wheuer/LED-Dodecahedron/README.md

# LED-Dodecahedron

This repository tracks the most recent state of my LED dodecahedron project.

It's a mess and unpolished. For a more in depth look at the project and it's history see [my website](https://www.williamfheuer.com/project-portfolio).
