wheuer/LED-Dodecahedron/KiCad/LEDSphere/LEDSphere.kicad_pcb

## KiCad design KiCad/LEDSphere/LEDSphere.kicad_pcb (2025-01-10)

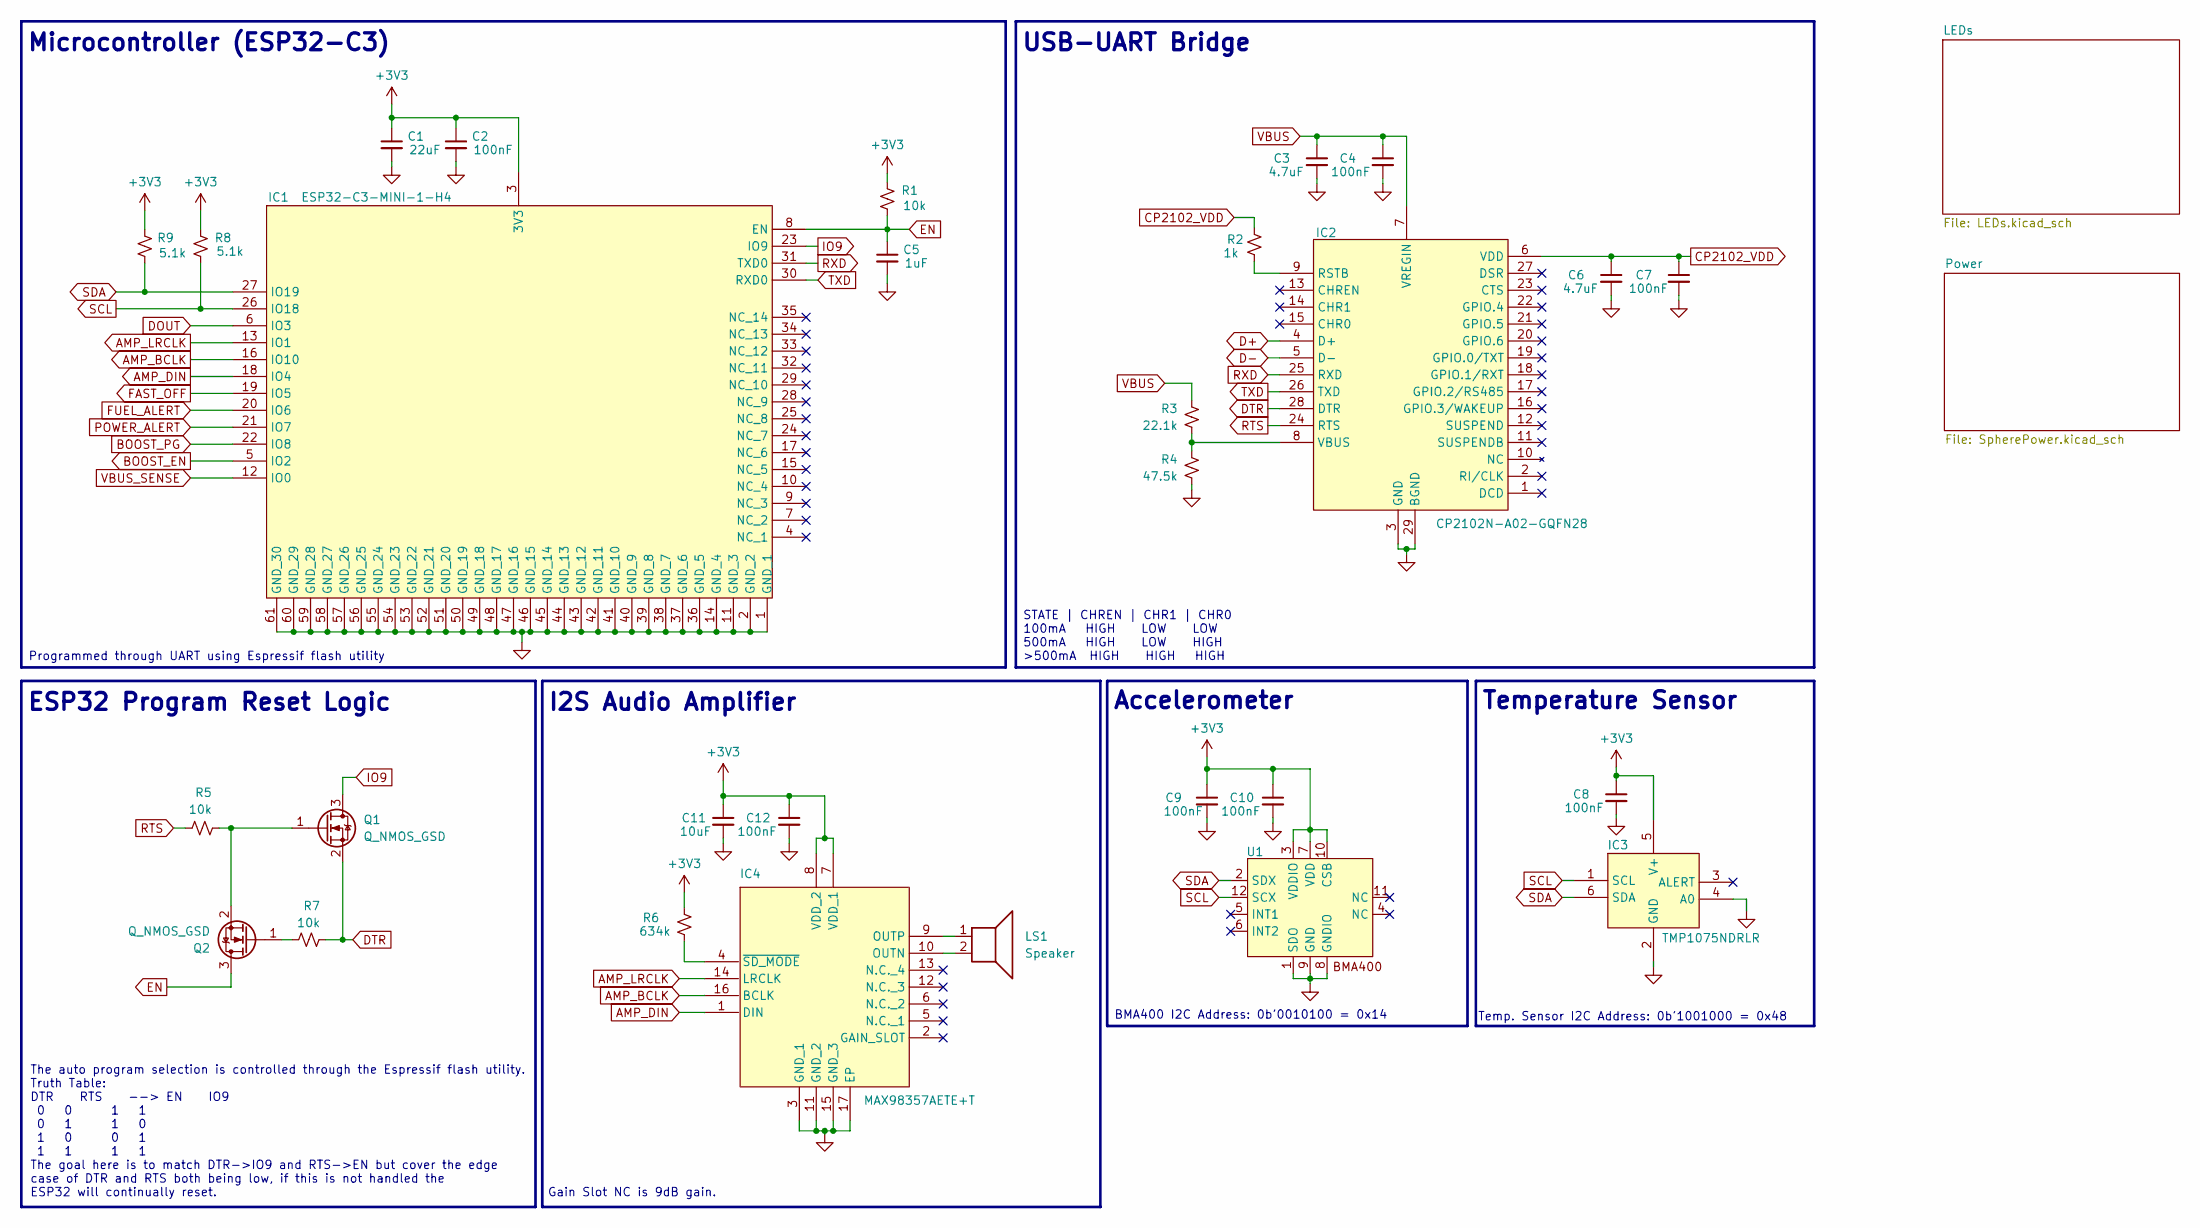
[picture p1: schematic LEDSphere.kicad_sch]

Parts:
C1: 22uF; C_0603_1608Metric
C2, C4, C7, C8, C9, C10, C12: 100nF; C_0402_1005Metric
C3, C6: 4.7uF; C_0402_1005Metric
C5: 1uF; C_0402_1005Metric
C11: 10uF; C_0603_1608Metric
IC1: ESP32-C3-MINI-1-H4; ESP32C3MINI1H4; Mouser Part Number 356-ESP32-C3-MINI1H4
IC2: CP2102N-A02-GQFN28; cp2102_QFN50P500X500X80-29N-D; Mouser Part Number 634-CP2102NA02GQFN28
IC3: TMP1075NDRLR; SOTFL50P160X60-6N; Mouser Part Number 595-TMP1075NDRLR
IC4: MAX98357AETE+T; QFN50P300X300X80-17N; Mouser Part Number 700-MAX98357AETE+T
LS1: Speaker; speakerPads
Q1, Q2: Q_NMOS_GSD; NMOS_SOT91P240X110-3N
R1, R5, R7: 10k; R_0402_1005Metric
R2: 1k; R_0402_1005Metric
R3: 22.1k; R_0402_1005Metric
R4: 47.5k; R_0402_1005Metric
R6: 634k; R_0402_1005Metric
R8, R9: 5.1k; R_0402_1005Metric
U1: BOSCH_LGA-12

Connections:
+3V3: C1.1, C2.1, C8.1, C9.1, C10.1, C11.1, C12.1, IC1.3 (3V3), IC3.5 (V+), IC4.7 (VDD_1), IC4.8 (VDD_2), R1.2, R6.2, R8.2, R9.2, U1.3 (VDDIO), U1.7 (VDD), U1.10 (CSB); also elsewhere on the board
AMP_BCLK: IC1.16 (IO10), IC4.16 (BCLK)
AMP_DIN: IC1.18 (IO4), IC4.1 (DIN)
AMP_LRCLK: IC1.13 (IO1), IC4.14 (LRCLK)
BOOST_EN: IC1.5 (IO2); also elsewhere on the board
BOOST_PG: IC1.22 (IO8); also elsewhere on the board
CP2102_VDD: C6.1, C7.1, IC2.6 (VDD), R2.1
D+: IC2.4 (D+); also elsewhere on the board
D-: IC2.5 (D-); also elsewhere on the board
DOUT: IC1.6 (IO3); also elsewhere on the board
DTR: IC2.28 (DTR), Q1.2 (S), R7.1
EN: C5.1, IC1.8 (EN), Q2.3 (D), R1.1
FAST_OFF: IC1.19 (IO5); also elsewhere on the board
FUEL_ALERT: IC1.20 (IO6); also elsewhere on the board
GND: C1.2, C2.2, C3.2, C4.2, C5.2, C6.2, C7.2, C8.2, C9.2, C10.2, C11.2, C12.2, IC1.1 (GND_1), IC1.2 (GND_2), IC1.11 (GND_3), IC1.14 (GND_4), IC1.36 (GND_5), IC1.37 (GND_6), IC1.38 (GND_7), IC1.39 (GND_8), IC1.40 (GND_9), IC1.41 (GND_10), IC1.42 (GND_11), IC1.43 (GND_12), IC1.44 (GND_13), IC1.45 (GND_14), IC1.46 (GND_15), IC1.47 (GND_16), IC1.48 (GND_17), IC1.49 (GND_18), IC1.50 (GND_19), IC1.51 (GND_20), IC1.52 (GND_21), IC1.53 (GND_22), IC1.54 (GND_23), IC1.55 (GND_24), IC1.56 (GND_25), IC1.57 (GND_26), IC1.58 (GND_27), IC1.59 (GND_28), IC1.60 (GND_29), IC1.61 (GND_30), IC2.3 (GND), IC2.29 (BGND), IC3.2 (GND), IC3.4 (A0), IC4.3 (GND_1), IC4.11 (GND_2), IC4.15 (GND_3), IC4.17 (EP), R4.2, U1.1 (SDO), U1.8 (GNDIO), U1.9 (GND); also elsewhere on the board
IO9: IC1.23 (IO9), Q1.3 (D)
unnamed: IC2.9 (RSTB), R2.2
unnamed: IC2.8 (VBUS), R3.2, R4.1
unnamed: IC4.10 (OUTN), LS1.2
unnamed: IC4.9 (OUTP), LS1.1
unnamed: IC4.4 (~SD_MODE), R6.1
unnamed: Q1.1 (G), Q2.2 (S), R5.1
unnamed: Q2.1 (G), R7.2
POWER_ALERT: IC1.21 (IO7); also elsewhere on the board
RTS: IC2.24 (RTS), R5.2
RXD: IC1.31 (TXD0), IC2.25 (RXD)
SCL: IC1.26 (IO18), IC3.1 (SCL), R8.1, U1.12 (SCX); also elsewhere on the board
SDA: IC1.27 (IO19), IC3.6 (SDA), R9.1, U1.2 (SDX); also elsewhere on the board
TXD: IC1.30 (RXD0), IC2.26 (TXD)
VBUS: C3.1, C4.1, IC2.7 (VREGIN), R3.1; also elsewhere on the board
VBUS_SENSE: IC1.12 (IO0); also elsewhere on the board

Notes on the sheet:
I2S Audio Amplifier
Gain Slot NC is 9dB gain.
Temperature Sensor
Microcontroller (ESP32-C3)
Programmed through UART using Espressif flash utility
BMA400 I2C Address: 0b'0010100 = 0x14
The auto program selection is controlled through the Espressif flash utility. Truth Table: DTR RTS --> EN IO9 0 0 1 1 0 1 1 0 1 0 0 1 1 1 1 1 The goal here is to match DTR->IO9 and RTS->EN but cover the edge case of DTR and RTS both being low, if this is not handled the ESP32 will continually reset.
STATE | CHREN | CHR1 | CHR0 100mA HIGH LOW LOW 500mA HIGH LOW HIGH >500mA HIGH HIGH HIGH
Temp. Sensor I2C Address: 0b'1001000 = 0x48
Accelerometer
USB-UART Bridge
ESP32 Program Reset Logic

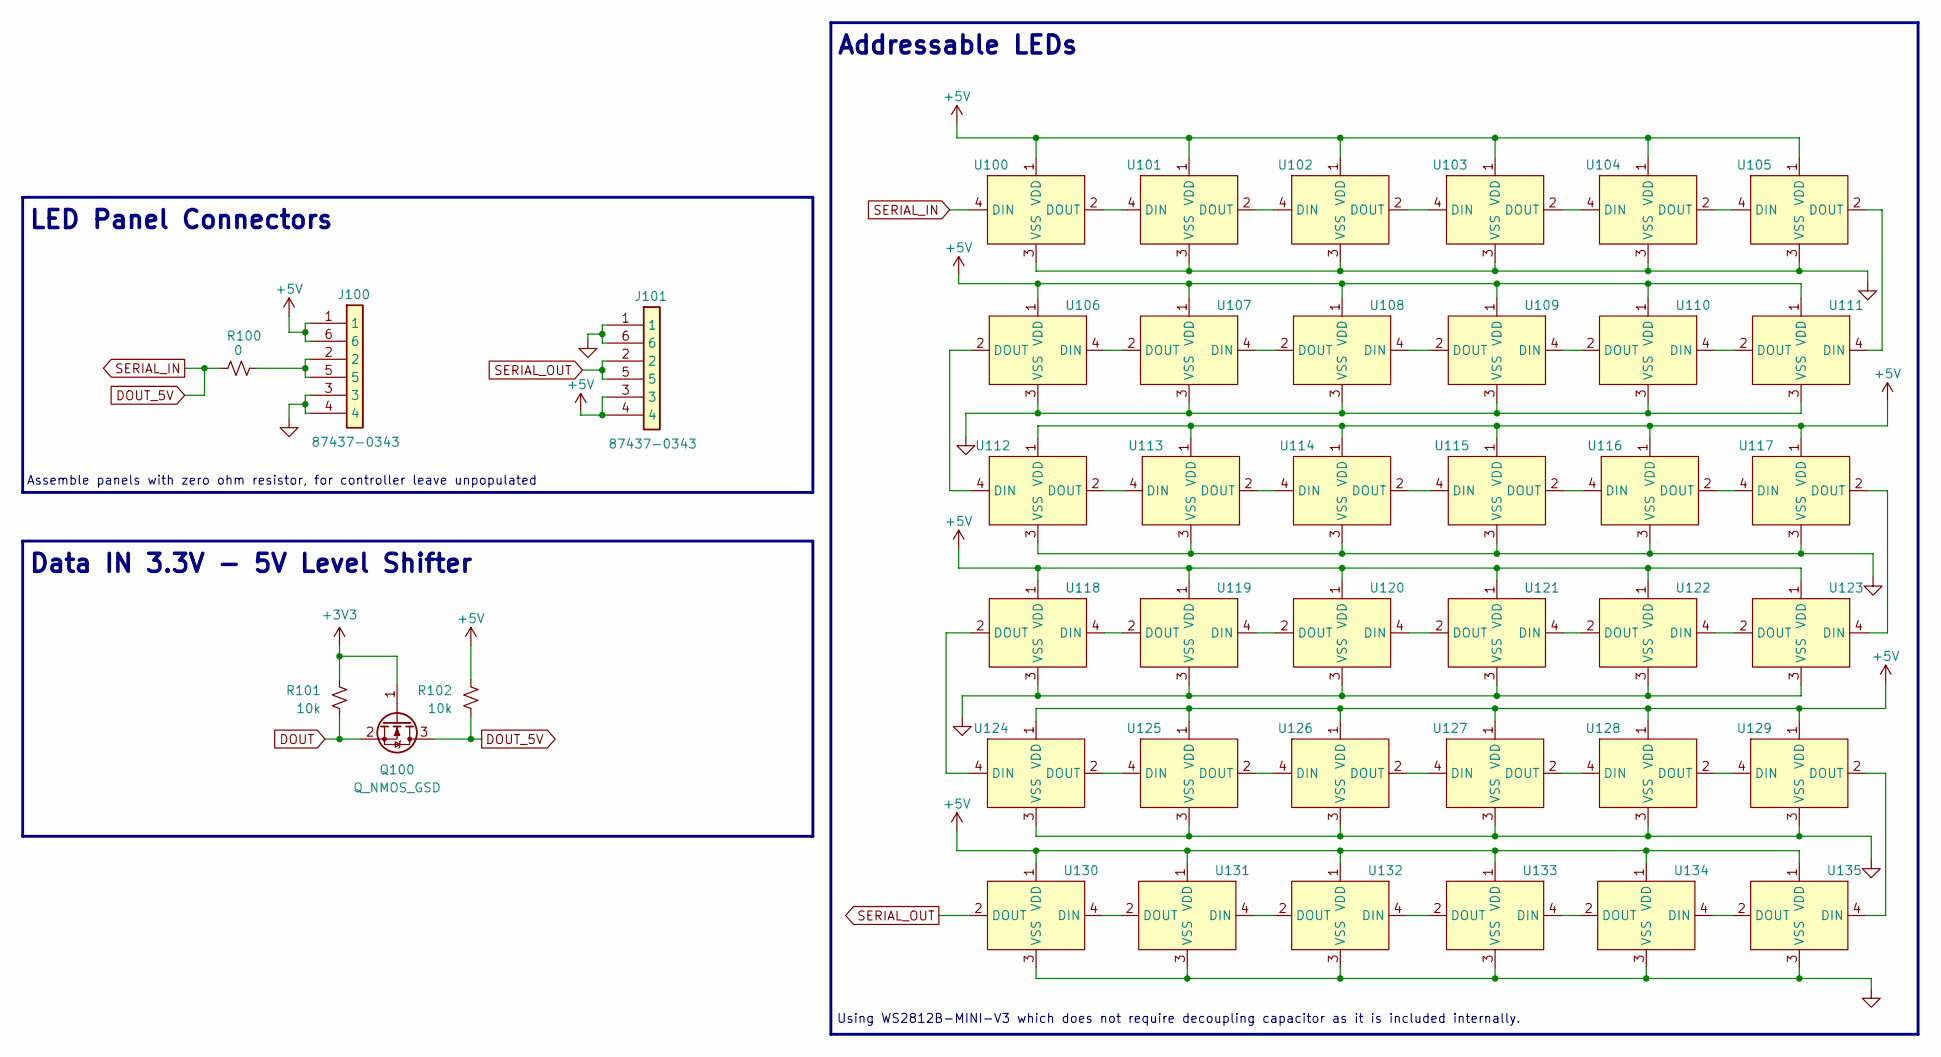
[picture p2: schematic LEDs.kicad_sch]

Parts:
J100, J101: 87437-0343; 874370343; Mouser Part Number 538-87437-0343
Q100: Q_NMOS_GSD; NMOS_SOT91P240X110-3N
R100: 0; R_0402_1005Metric
R101, R102: 10k; R_0402_1005Metric
U100, U101, U102, U103, U104, U105, U106, U107, U108, U109, U110, U111, U112, U113, U114, U115, U116, U117, U118, U119, U120, U121, U122, U123, U124, U125, U126, U127, U128, U129, U130, U131, U132, U133, U134, U135: WS2812-W-MINI

Connections:
+3V3: Q100.1 (G), R101.1; also elsewhere on the board
+5V: J100.1, J100.6, J101.3, J101.4, R102.1, U100.1 (VDD), U101.1 (VDD), U102.1 (VDD), U103.1 (VDD), U104.1 (VDD), U105.1 (VDD), U106.1 (VDD), U107.1 (VDD), U108.1 (VDD), U109.1 (VDD), U110.1 (VDD), U111.1 (VDD), U112.1 (VDD), U113.1 (VDD), U114.1 (VDD), U115.1 (VDD), U116.1 (VDD), U117.1 (VDD), U118.1 (VDD), U119.1 (VDD), U120.1 (VDD), U121.1 (VDD), U122.1 (VDD), U123.1 (VDD), U124.1 (VDD), U125.1 (VDD), U126.1 (VDD), U127.1 (VDD), U128.1 (VDD), U129.1 (VDD), U130.1 (VDD), U131.1 (VDD), U132.1 (VDD), U133.1 (VDD), U134.1 (VDD), U135.1 (VDD); also elsewhere on the board
DOUT: Q100.2 (S), R101.2; also elsewhere on the board
DOUT_5V: Q100.3 (D), R100.1, R102.2, U100.4 (DIN)
GND: J100.3, J100.4, J101.1, J101.6, U100.3 (VSS), U101.3 (VSS), U102.3 (VSS), U103.3 (VSS), U104.3 (VSS), U105.3 (VSS), U106.3 (VSS), U107.3 (VSS), U108.3 (VSS), U109.3 (VSS), U110.3 (VSS), U111.3 (VSS), U112.3 (VSS), U113.3 (VSS), U114.3 (VSS), U115.3 (VSS), U116.3 (VSS), U117.3 (VSS), U118.3 (VSS), U119.3 (VSS), U120.3 (VSS), U121.3 (VSS), U122.3 (VSS), U123.3 (VSS), U124.3 (VSS), U125.3 (VSS), U126.3 (VSS), U127.3 (VSS), U128.3 (VSS), U129.3 (VSS), U130.3 (VSS), U131.3 (VSS), U132.3 (VSS), U133.3 (VSS), U134.3 (VSS), U135.3 (VSS); also elsewhere on the board
unnamed: J100.2, J100.5, R100.2
unnamed: U100.2 (DOUT), U101.4 (DIN)
unnamed: U101.2 (DOUT), U102.4 (DIN)
unnamed: U102.2 (DOUT), U103.4 (DIN)
unnamed: U103.2 (DOUT), U104.4 (DIN)
unnamed: U104.2 (DOUT), U105.4 (DIN)
unnamed: U105.2 (DOUT), U111.4 (DIN)
unnamed: U106.4 (DIN), U107.2 (DOUT)
unnamed: U106.2 (DOUT), U112.4 (DIN)
unnamed: U107.4 (DIN), U108.2 (DOUT)
unnamed: U108.4 (DIN), U109.2 (DOUT)
unnamed: U109.4 (DIN), U110.2 (DOUT)
unnamed: U110.4 (DIN), U111.2 (DOUT)
unnamed: U112.2 (DOUT), U113.4 (DIN)
unnamed: U113.2 (DOUT), U114.4 (DIN)
unnamed: U114.2 (DOUT), U115.4 (DIN)
unnamed: U115.2 (DOUT), U116.4 (DIN)
unnamed: U116.2 (DOUT), U117.4 (DIN)
unnamed: U117.2 (DOUT), U123.4 (DIN)
unnamed: U118.4 (DIN), U119.2 (DOUT)
unnamed: U118.2 (DOUT), U124.4 (DIN)
unnamed: U119.4 (DIN), U120.2 (DOUT)
unnamed: U120.4 (DIN), U121.2 (DOUT)
unnamed: U121.4 (DIN), U122.2 (DOUT)
unnamed: U122.4 (DIN), U123.2 (DOUT)
unnamed: U124.2 (DOUT), U125.4 (DIN)
unnamed: U125.2 (DOUT), U126.4 (DIN)
unnamed: U126.2 (DOUT), U127.4 (DIN)
unnamed: U127.2 (DOUT), U128.4 (DIN)
unnamed: U128.2 (DOUT), U129.4 (DIN)
unnamed: U129.2 (DOUT), U135.4 (DIN)
unnamed: U130.4 (DIN), U131.2 (DOUT)
unnamed: U131.4 (DIN), U132.2 (DOUT)
unnamed: U132.4 (DIN), U133.2 (DOUT)
unnamed: U133.4 (DIN), U134.2 (DOUT)
unnamed: U134.4 (DIN), U135.2 (DOUT)
SERIAL_OUT: J101.2, J101.5, U130.2 (DOUT)

Notes on the sheet:
LED Panel Connectors
Addressable LEDs
Data IN 3.3V - 5V Level Shifter
Assemble panels with zero ohm resistor, for controller leave unpopulated
Using WS2812B-MINI-V3 which does not require decoupling capacitor as it is included internally.

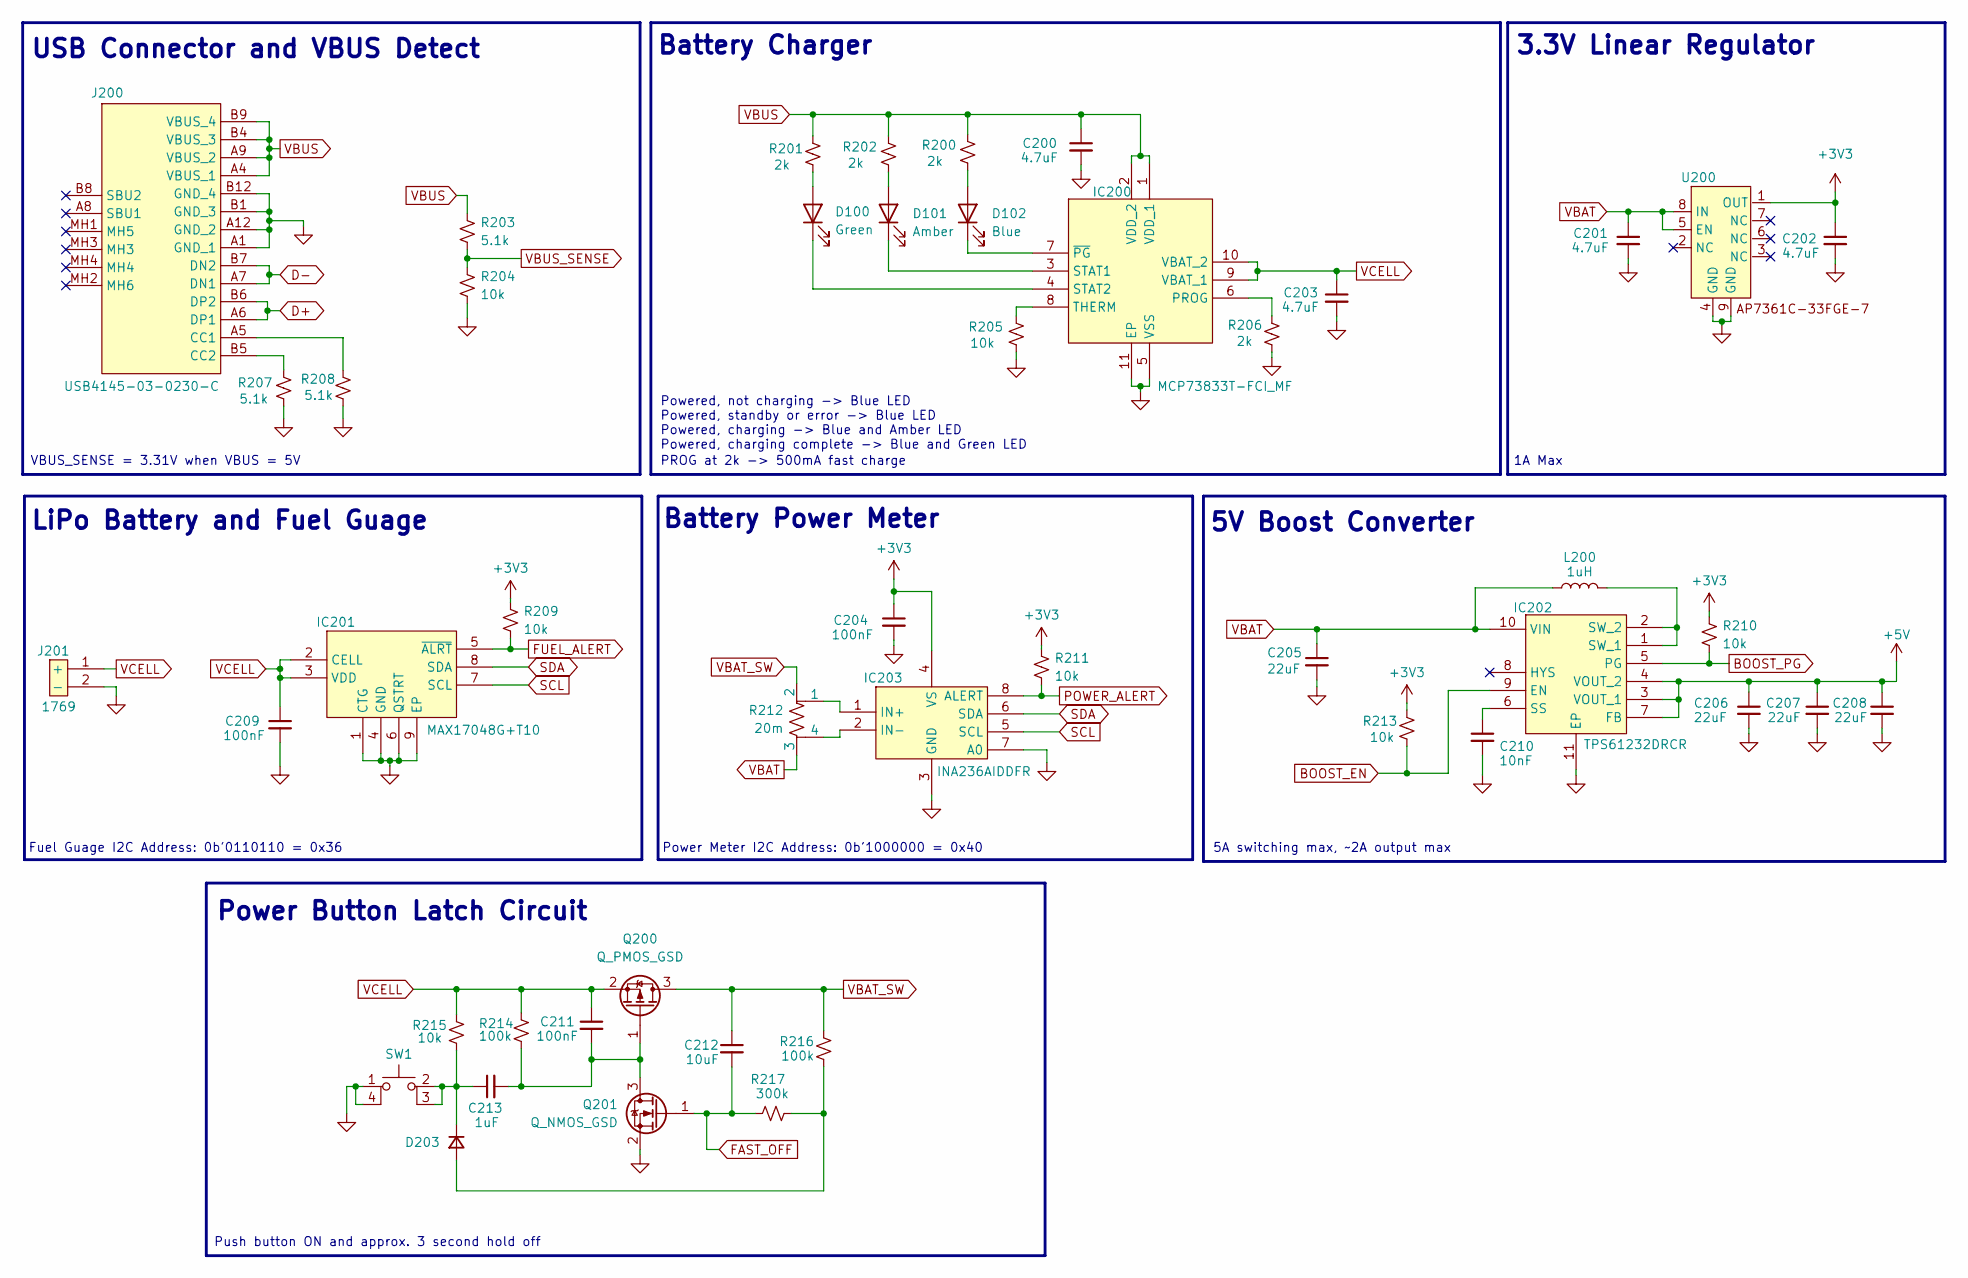
[picture p3: schematic SpherePower.kicad_sch]

Parts:
C200, C201, C202, C203: 4.7uF; C_0402_1005Metric
C204, C209, C211: 100nF; C_0402_1005Metric
C205, C206, C207, C208: 22uF; C_0603_1608Metric
C210: 10nF; C_0402_1005Metric
C212: 10uF; C_0603_1608Metric
C213: 1uF; C_0402_1005Metric
D100: Green; LED_0402_1005Metric
D101: Amber; LED_0402_1005Metric
D102: Blue; LED_0402_1005Metric
D203: D_Small; D_SOD-123F
IC200: MCP73833T-FCI_MF; batteryChg_SON50P300X300X100-11N-D; Mouser Part Number 579-MCP73833T-FCI/MF
IC201: MAX17048G+T10; SON50P200X200X80-9N-D; Mouser Part Number 700-MAX17048G+T10
IC202: TPS61232DRCR; boost_SON50P300X300X100-11N-D; Mouser Part Number 595-TPS61232DRCR
IC203: INA236AIDDFR; SOP65P280X110-8N; Mouser Part Number 595-INA236AIDDFR
J200: USB4145-03-0230-C; vertical_USB4145030230C; Mouser Part Number 640-USB4145-3-0230-C
J201: 1769; Mouser Part Number 485-1769
L200: 1uH; boostInductor_XFL4020
Q200: Q_PMOS_GSD; SSM3J332RLFT
Q201: Q_NMOS_GSD; NMOS_SOT91P240X110-3N
R200, R201, R202, R206: 2k; R_0402_1005Metric
R203, R207, R208: 5.1k; R_0402_1005Metric
R204, R205, R209, R210, R211, R213, R215: 10k; R_0402_1005Metric
R212: 20m; shunt_LVK12R020DER
R214, R216: 100k; R_0402_1005Metric
R217: 300k; R_0402_1005Metric
SW1: button_KMR_2
U200: linearReg_SON65P300X300X63-9N

Connections:
+3V3: C202.1, C204.1, IC203.4 (VS), R209.2, R210.2, R211.2, R213.2, U200.1 (OUT); also elsewhere on the board
+5V: C206.1, C207.1, C208.1, IC202.3 (VOUT_1), IC202.4 (VOUT_2), IC202.7 (FB); also elsewhere on the board
BOOST_EN: IC202.9 (EN), R213.1; also elsewhere on the board
BOOST_PG: IC202.5 (PG), R210.1; also elsewhere on the board
D+: J200.A6 (DP1), J200.B6 (DP2); also elsewhere on the board
D-: J200.A7 (DN1), J200.B7 (DN2); also elsewhere on the board
FAST_OFF: C212.2, Q201.1 (G), R217.2; also elsewhere on the board
FUEL_ALERT: IC201.5 (~ALRT), R209.1; also elsewhere on the board
GND: C200.2, C201.2, C202.2, C203.2, C204.2, C205.2, C206.2, C207.2, C208.2, C209.2, C210.2, IC200.5 (VSS), IC200.11 (EP), IC201.1 (CTG), IC201.4 (GND), IC201.6 (QSTRT), IC201.9 (EP), IC202.11 (EP), IC203.3 (GND), IC203.7 (A0), J200.A1 (GND_1), J200.A12 (GND_2), J200.B1 (GND_3), J200.B12 (GND_4), J201.2 (-), Q201.2 (S), R204.1, R205.1, R206.1, R207.1, R208.1, SW1.1, SW1.4, U200.4 (GND), U200.9 (GND); also elsewhere on the board
unnamed 18: R201.1; also elsewhere on the board
unnamed 19: IC200.4 (STAT2); also elsewhere on the board
unnamed 20: R202.1; also elsewhere on the board
unnamed 21: IC200.3 (STAT1); also elsewhere on the board
unnamed 22: R200.1; also elsewhere on the board
unnamed 23: IC200.7 (~PG); also elsewhere on the board
unnamed: D203.2 (A), R216.1, R217.1
unnamed: C213.1, D203.1 (K), R215.1, SW1.2, SW1.3
unnamed: IC200.6 (PROG), R206.2
unnamed: IC200.8 (THERM), R205.2
unnamed: C210.1, IC202.6 (SS)
unnamed: IC202.1 (SW_1), IC202.2 (SW_2), L200.2
unnamed: IC203.1 (IN+), R212.1
unnamed: IC203.2 (IN-), R212.4
unnamed: J200.A5 (CC1), R208.2
unnamed: J200.B5 (CC2), R207.2
unnamed: C211.2, C213.2, Q200.1 (G), Q201.3 (D), R214.1
POWER_ALERT: IC203.8 (ALERT), R211.1; also elsewhere on the board
SCL: IC201.7 (SCL), IC203.5 (SCL); also elsewhere on the board
SDA: IC201.8 (SDA), IC203.6 (SDA); also elsewhere on the board
VBAT: C201.1, C205.1, IC202.10 (VIN), L200.1, R212.3, U200.5 (EN), U200.8 (IN)
VBAT_SW: C212.1, Q200.3 (D), R212.2, R216.2
VBUS: C200.1, IC200.1 (VDD_1), IC200.2 (VDD_2), J200.A4 (VBUS_1), J200.A9 (VBUS_2), J200.B4 (VBUS_3), J200.B9 (VBUS_4), R200.2, R201.2, R202.2, R203.2; also elsewhere on the board
VBUS_SENSE: R203.1, R204.2; also elsewhere on the board
VCELL: C203.1, C209.1, C211.1, IC200.9 (VBAT_1), IC200.10 (VBAT_2), IC201.2 (CELL), IC201.3 (VDD), J201.1 (+), Q200.2 (S), R214.2, R215.2

Notes on the sheet:
USB Connector and VBUS Detect
Fuel Guage I2C Address: 0b'0110110 = 0x36
5A switching max, ~2A output max
LiPo Battery and Fuel Guage
Powered, not charging -> Blue LED Powered, standby or error -> Blue LED Powered, charging -> Blue and Amber LED Powered, charging complete -> Blue and Green LED
5V Boost Converter
3.3V Linear Regulator
VBUS_SENSE = 3.31V when VBUS = 5V
Power Meter I2C Address: 0b'1000000 = 0x40
Battery Charger
Power Button Latch Circuit
PROG at 2k -> 500mA fast charge
Battery Power Meter
Push button ON and approx. 3 second hold off
1A Max

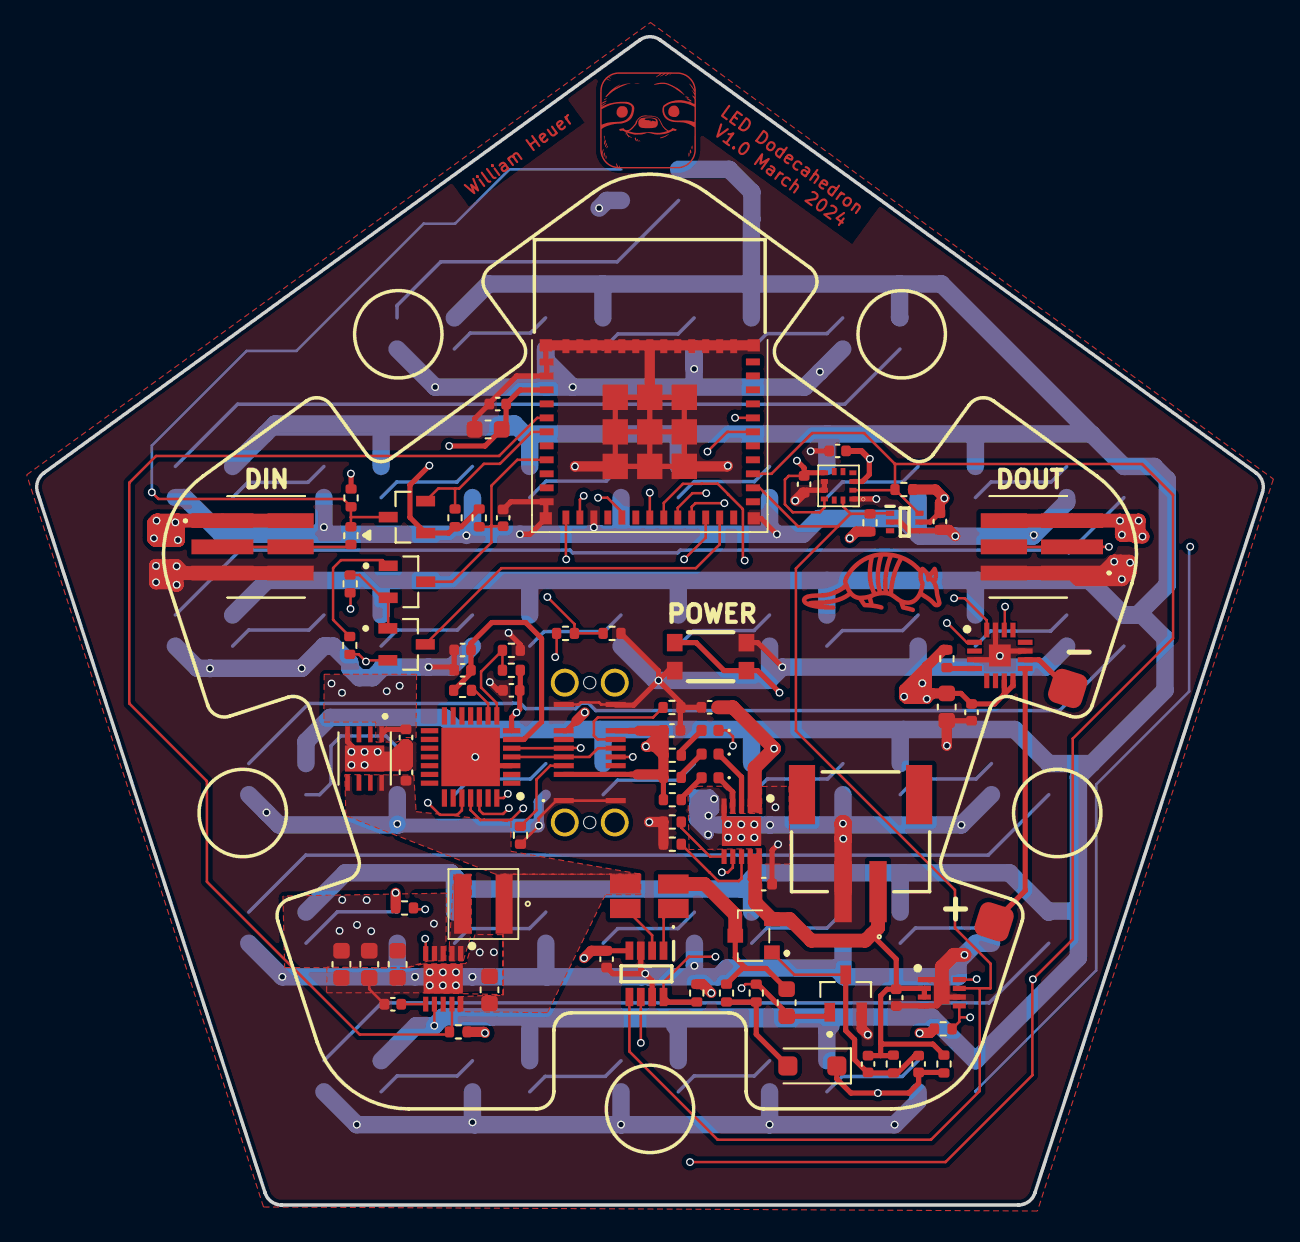
[picture p4: board LEDSphere.kicad_pcb from above]

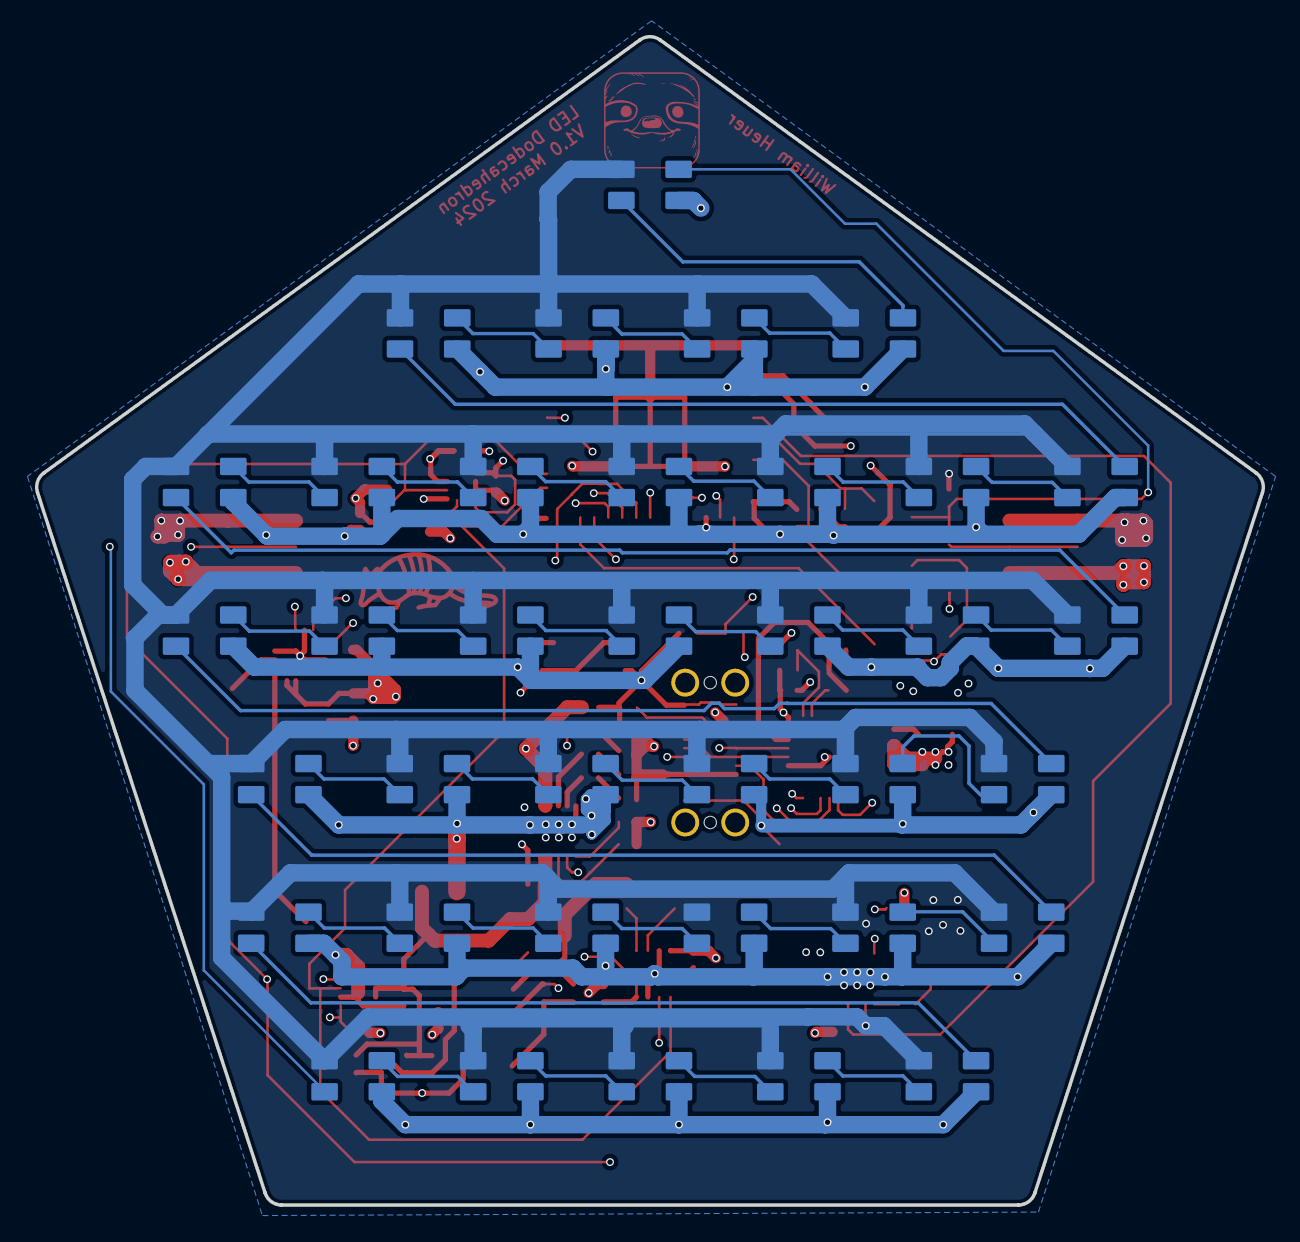
[picture p5: board LEDSphere.kicad_pcb from below]

Board: 4 copper layers, 70.2 x 66.8 mm, 118 parts (36 on the bottom side), 90 nets.

Other parts of the board:
D200: Green; LED_0402_1005Metric
D201: Amber; LED_0402_1005Metric
D202: Blue; LED_0402_1005Metric

Their connections:
unnamed 18: D200.2 (A); also elsewhere on the board
unnamed 19: D200.1 (K); also elsewhere on the board
unnamed 20: D201.2 (A); also elsewhere on the board
unnamed 21: D201.1 (K); also elsewhere on the board
unnamed 22: D202.2 (A); also elsewhere on the board
unnamed 23: D202.1 (K); also elsewhere on the board
