wheuer/LED-Dodecahedron/(commit log)

2025-01-10 [Firmware] Fuel gauge and temp sensor MVP's complete
    [LEDSphere-B_Cu.gbr, LEDSphere-B_Fab.gbr, LEDSphere-B_Mask.gbr, LEDSphere-B_Paste.gbr, LEDSphere-B_Silkscreen.gbr, LEDSphere-Edge_Cuts.gbr, LEDSphere-F_Cu.gbr, LEDSphere-F_Mask.gbr]
2025-01-12 [Firmware] Minimum LED and power meter MVP complete
2025-01-16 [Firmware] Main system loop coming along, almost at total MVP. Still an issue with switching to and from NONE effect
    [fuel_gauge.c, led_panels.c, led_panels.h, main.c]
